thescrawler/cbhb/downloads/README.md

Sideload APKs and firmware files are hosted as GitHub Release assets, not in this folder.

Current and previous downloads: https://github.com/thescrawler/cbhb/releases

The website points at those same files:
- https://thescrawler.github.io/cbhb/meshcore-one-stop.html
- https://thescrawler.github.io/cbhb/firmware.html
