thescrawler/cbhb/assets/mesh-tools-phone.png

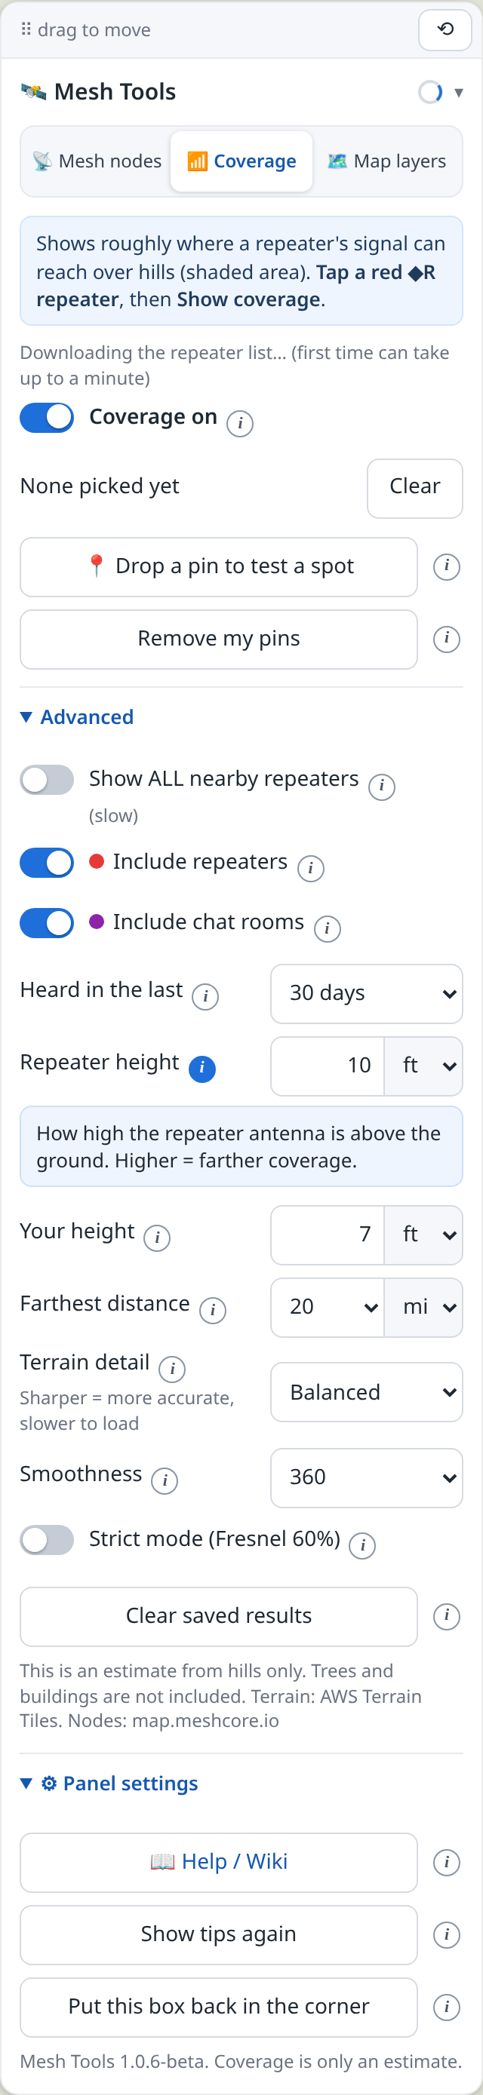
assets/mesh-tools-phone.png
