thescrawler/cbhb/files/solar-node/solar_monitor_schematic.png

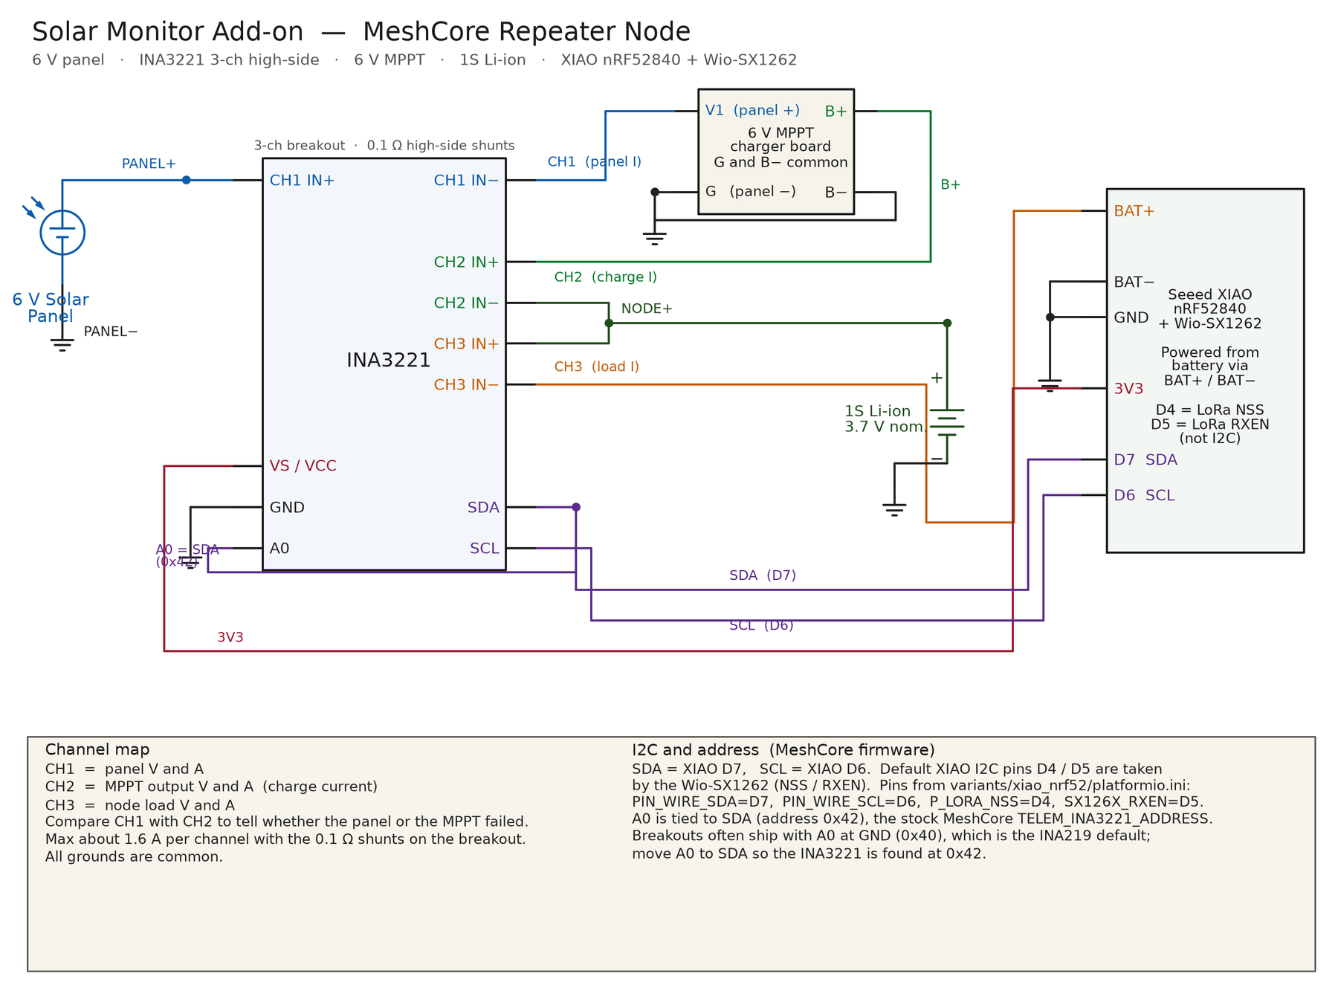
files/solar-node/solar_monitor_schematic.png
