thescrawler/cbhb/files/solar-node/solar_node_preview.png

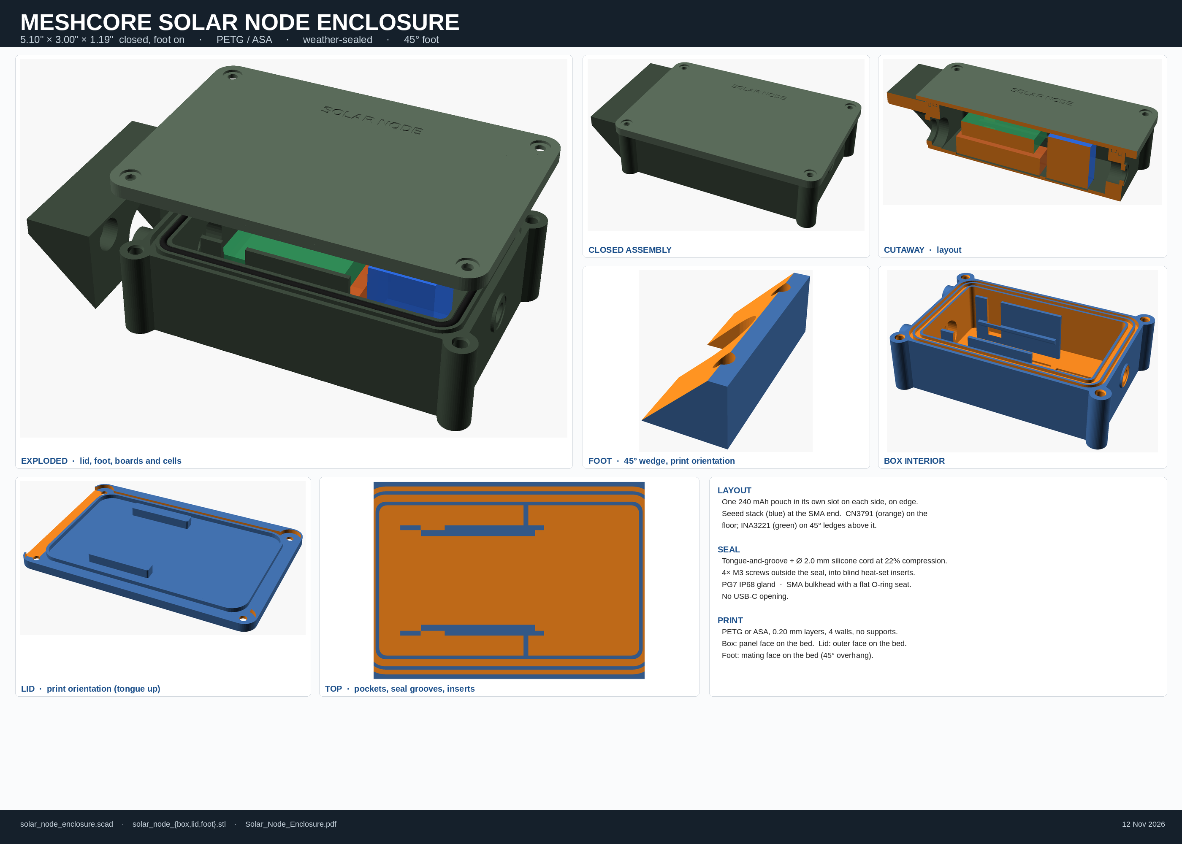
files/solar-node/solar_node_preview.png
