thescrawler/cbhb/files/solar-node/solar_node_foot.stl

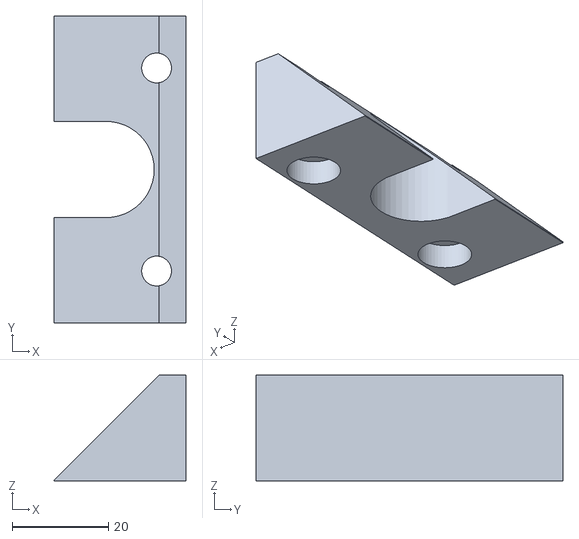
[picture p6: CAD file, 2026-11-13]
files/solar-node/solar_node_foot.stl
27.4 x 63.8 x 22.0
