thescrawler/cbhb/files/solar-node/solar_node_box.stl

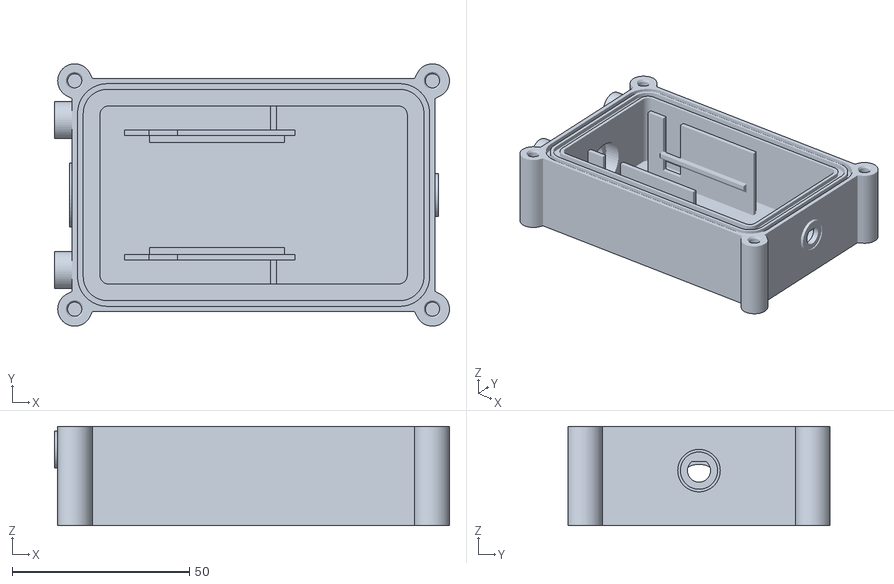
[picture p7: CAD file, 2026-11-13]
files/solar-node/solar_node_box.stl
111.4 x 74.0 x 28.0
