thescrawler/cbhb/files/solar-node/solar_node_lid.stl

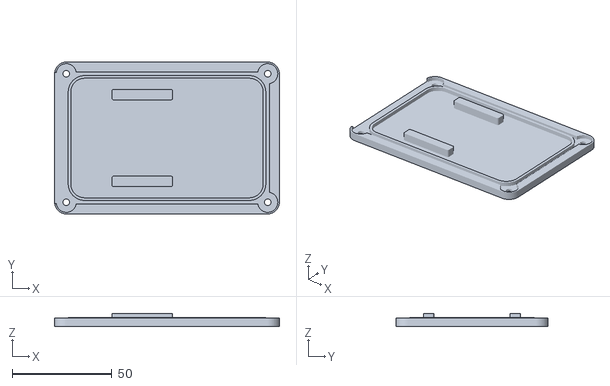
[picture p8: CAD file, 2026-11-13]
files/solar-node/solar_node_lid.stl
112.7 x 76.2 x 6.50
