thescrawler/cbhb/files/solar-node/Solar_Monitor_Build_Sheet.pdf

Solar Monitor Add-on, MeshCore Repeater (XIAO nRF52840 + Wio-SX1262) | Nov 12, 2026 | · | 1 of 3

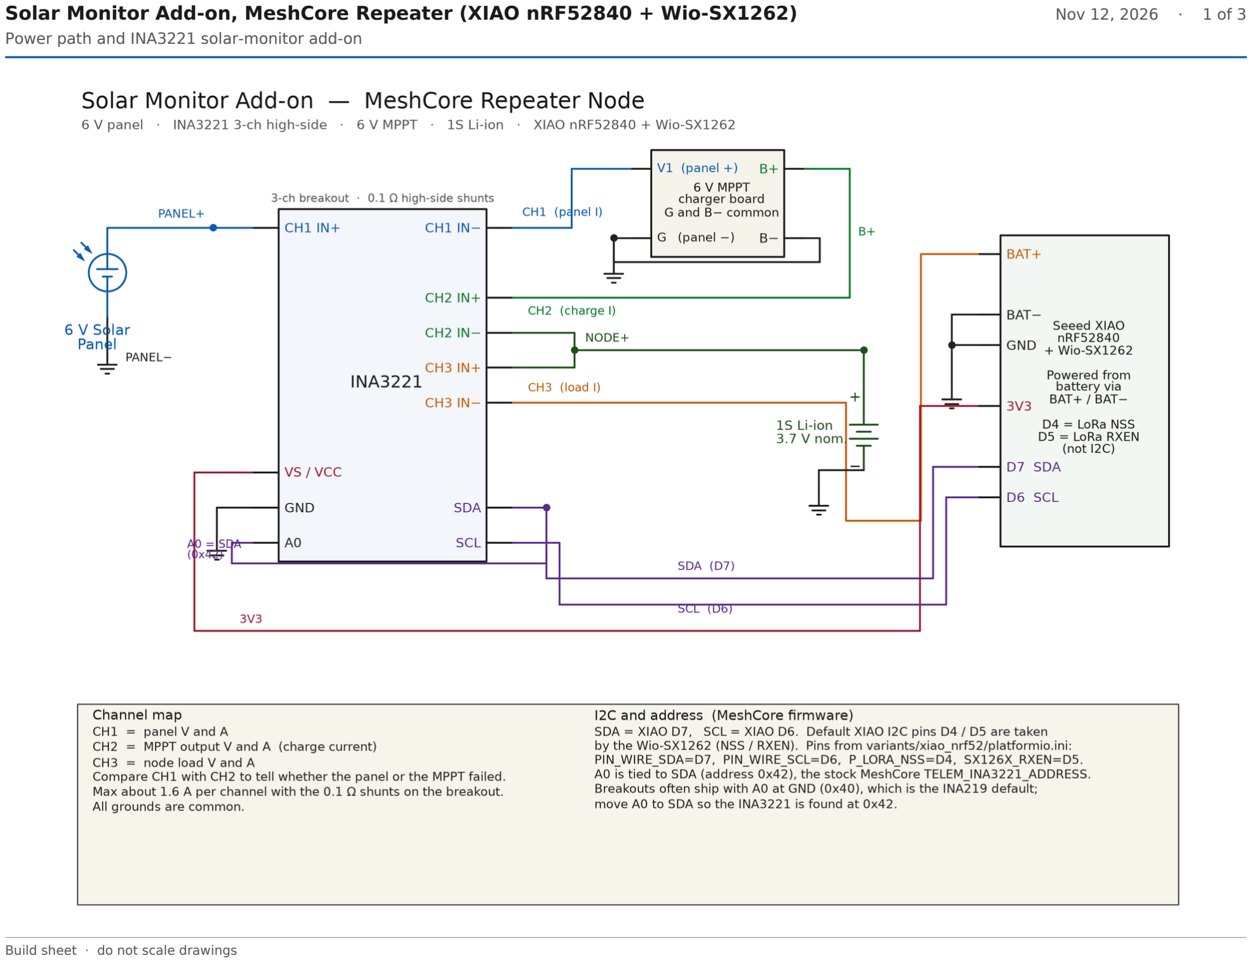
[picture p9: page 1]

Power path and INA3221 solar-monitor add-on

Build sheet · do not scale drawings

Solar Monitor Add-on, MeshCore Repeater (XIAO nRF52840 + Wio-SX1262) | Nov 12, 2026 | · | 2 of 3
XIAO nRF52840 ↔ Wio-SX1262 point-to-point wiring

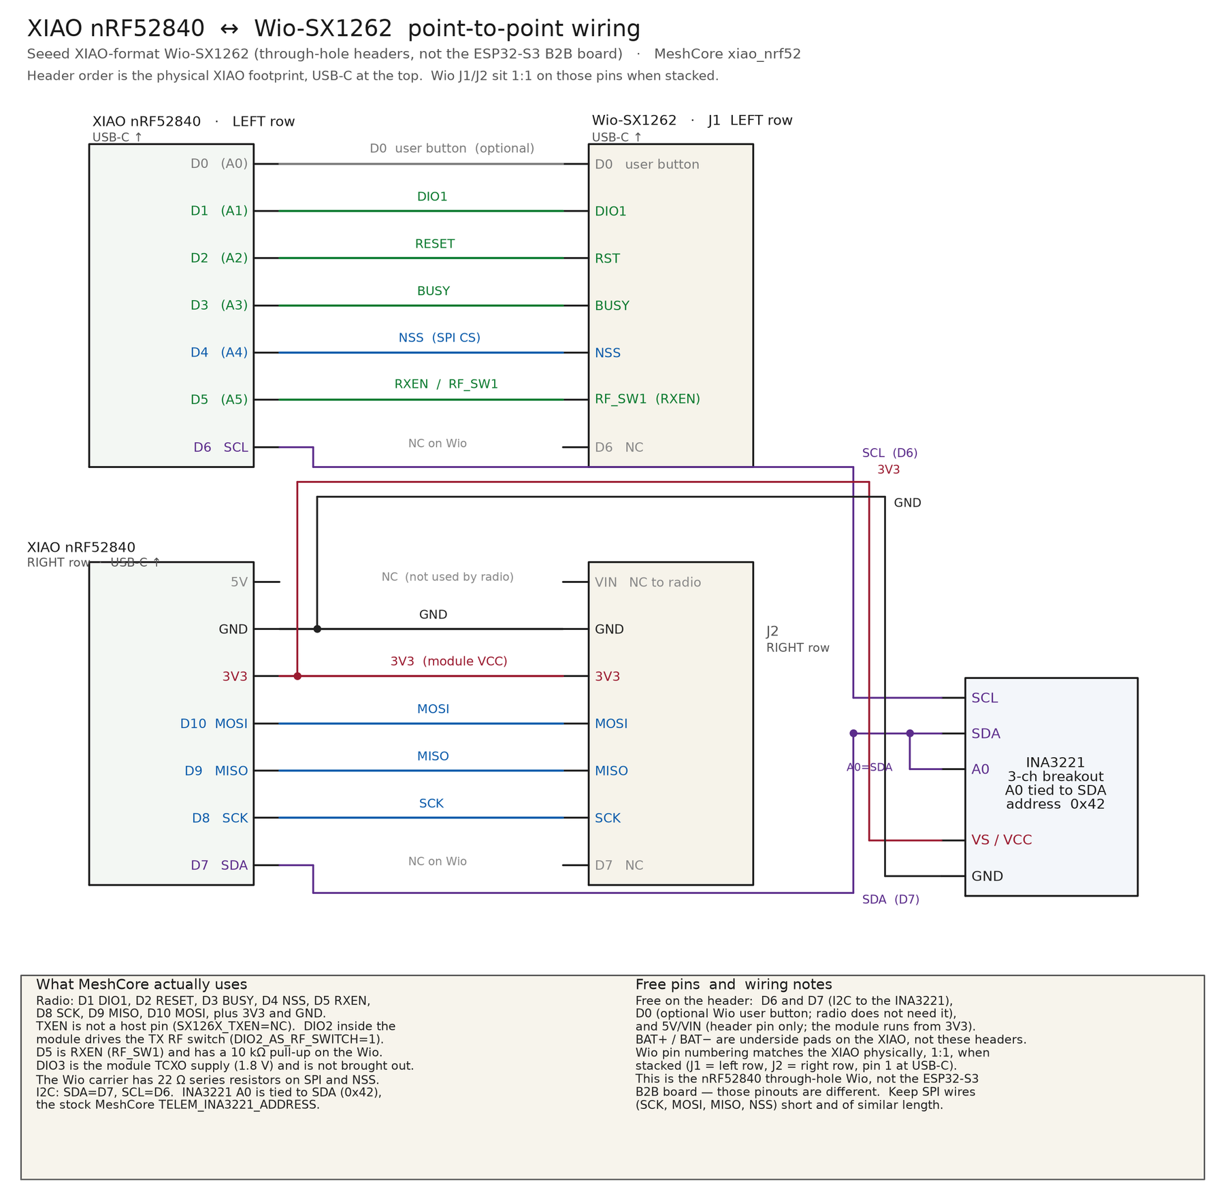
[picture p10: figure]

Solar Monitor Add-on, MeshCore Repeater (XIAO nRF52840 + Wio-SX1262) | Nov 12, 2026 | · | 3 of 3
Special notes for this build

INA3221 board
MusRock INA3221 3-pack (Amazon ASIN B0FTF9LC1T). Marked 100 mΩ (R100) shunts, which match MeshCore’s default 0.1 Ω. Verify the shunts actually read R100 before stuffing the board.

I2C address
The breakout ships at 0x40. Move A0 to SDA for 0x42 — that is the address stock MeshCore probes for the INA3221 (TELEM_INA3221_ADDRESS). 0x40 is the INA219 default and can be misdetected as one.

I2C pins
D7 = SDA, D6 = SCL. D4 and D5 are the radio’s NSS and RXEN, not I2C. Source: MeshCore variants/xiao_nrf52/platformio.ini (PIN_WIRE_SDA=D7, PIN_WIRE_SCL=D6, P_LORA_NSS=D4, SX126X_RXEN=D5).

Channel map
CH1 = panel V and A. CH2 = MPPT output V and A (charge). CH3 = node load V and A. CH1 power with CH2 near zero means the MPPT is the problem; low CH1 in sun means the panel.

Shunt rating
Max about 1.6 A per channel with the 0.1 Ω shunts.

MPPT pads
V1 = panel +. G = panel −. B+ / B− = battery. G and B− are assumed common — confirm with a continuity check on the actual board.

Radio wiring
Used: D1 (DIO1), D2 (RESET), D3 (BUSY), D4 (NSS), D5 (RXEN), D8 (SCK), D9 (MISO), D10 (MOSI), 3V3, GND. Free: D0 (Wio user button only), D6, D7, 5V. TX switch is DIO2 inside the module; there is no TXEN pin.

Firmware
Stock MeshCore — and the v1.18.0-jp.wdt build based on it — already includes INA3221 support. Bench-test with a telemetry pull first; no firmware change is expected.

Telemetry
CayenneLPP power reports in whole watts, so small loads can show 0 W even when V and A are correct.
