thescrawler/cbhb/(commit log)

2026-11-13 Host app and firmware downloads as GitHub Release assets.
    Move the sideload APKs and firmware images out of the website tree so the repo does not keep growing with 93 MB files. Site links now point at release assets. Previous versions are listed for rollback: One Stop 99.1.7, 99.1.6, and 99.1.5, plus repeater firmware jp.wdt2 and jp.wdt. 99.1.7 uses a new signing key, so switching to or from 99.1.6 requires an uninstall first.
2026-11-13 Add solar logging node and Camp Mode build guides.
    Publish readable instructions for jp.wdt2 with INA3221 solar logging and for jp.crep1 Camp Mode in One Stop 99.1.7. Include the existing enclosure drawings and print files, plus an SVG wiring diagram from the firmware pin map. Product links are only to pages that were checked.
    [solar_node_box.stl, solar_node_enclosure.scad, solar_node_foot.stl, solar_node_lid.stl]
2026-11-13 Remove Heltec V3 firmware and name every board exactly.
    Drop the Heltec LoRa32 V3 / ESP32 crep1 image and its 0x0 flash notes. The site now supports only the Seeed XIAO nRF52840 + Wio-SX1262 (files available), RAK4631 WisBlock (RAK19003 base), and Heltec T096 (those two builds coming). Firmware pages, release notes, and guides name the exact board for each file.
2026-11-13 Add RAK4631 and Heltec T096 test firmware and jp.croom1.
    Post board-specific UF2s for jp.wdt2, jp.crep1, and jp.croom1, with SHA-256, test-build labels, and earlier XIAO images kept for rollback.
